svirant/RT4k_HD15_serial_control/HDMI Generic/README.md

## HDMI Generic

This guide should work with any switch that uses LEDs to indicate which input is active.

Picture guide coming soon...
