svirant/RT4k_HD15_serial_control/HDMI Generic/assets/6.jpeg

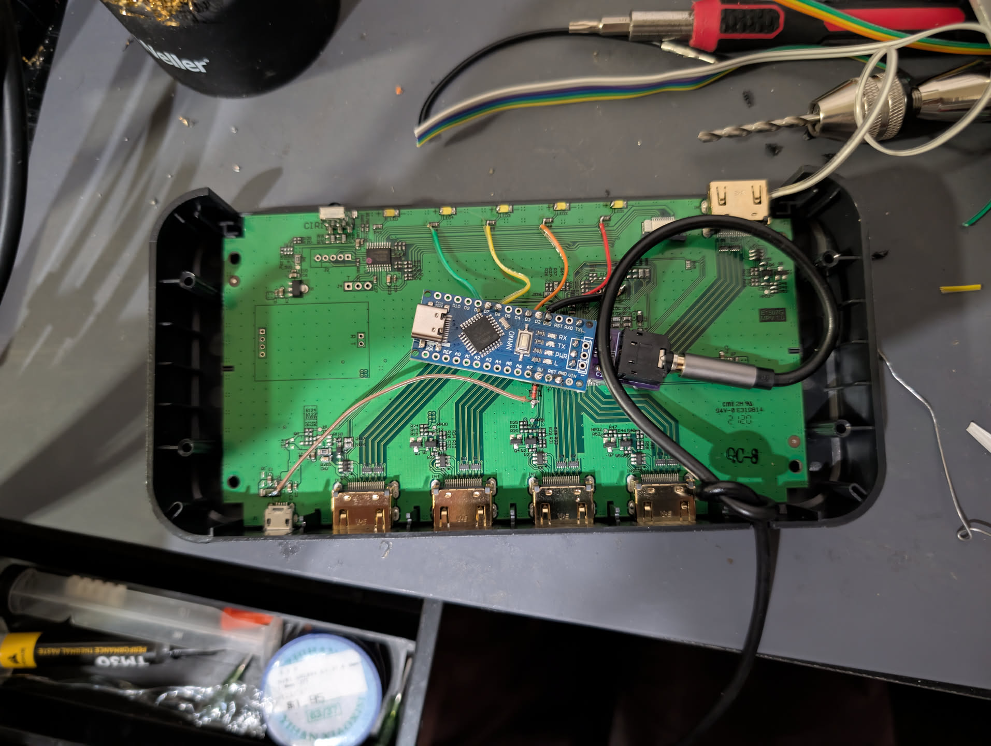
HDMI Generic/assets/6.jpeg
