svirant/RT4k_HD15_serial_control/DonutDongle/BOM-DonutDongle.csv

Comment | Quantity | Designator | Footprint | Part# | Digikey | AliExpress
Donut Dongle
0.1 uf / 100nf Capacitor | 4 | C1,C2,C3,C4 | C_0805_2012Metric | 311-1140-1-ND | https://www.digikey.com/en/products/detail/yageo/CC0805KRX7R9BB104/302874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
30 Ohm Resistor | 1 | R1 | R_0805_2012Metric | 10-ERJ-P06F30R0VCT-ND | https://www.digikey.com/en/products/detail/panasonic-electronic-components/ERJ-P06J102V/525197
1K Ohm Resistor | 1 | R2 | R_0805_2012Metric | P1.0KADCT-ND | https://www.digikey.com/en/products/detail/panasonic-electronic-components/ERJ-P06J102V/525197
10K Ohm Resistor | 6 | R3,R4,R5,R6,R7,R8 | R_0805_2012Metric | 311-10KLGCT-ND | https://www.digikey.com/en/products/detail/yageo/AC0805FR-0710KL/2827834
PJ-307 3.5mm Stereo Jack Socket Audio Jack Connector PCB 3F07 | 1 |  |  | PJ-307 |  | https://www.aliexpress.us/item/2251832712518602.html?sourceType=1
PJ-320 3.5MM Headphone Jack Audio Video Female | 4 |  |  | PJ-320 |  | https://www.aliexpress.us/item/3256805995568762.html?sourceType=1
DC3 10 Pin 2x5 Pin Double Row 2.54mm Pitch Straight Pin Male IDC Box Header Connector | 2 |  | 2x5 pin |  |  | https://www.aliexpress.us/item/2255800441397852.html?sourceType=1
2.54mm 2x4 Pin 8 Pin Straight Male Shrouded PCB Box header IDC Socket | 2 |  | 2x4 pin |  |  | https://www.aliexpress.us/item/2251801533534895.html?sourceType=1
CHF03 1.5 Meters IR Infrared Remote Emission Cable IR Emitter 5ft Emission Lines Extender Cord for IR Repeater Kit | 1 |  | 3.5mm TS male jack (optional) |  |  | https://www.aliexpress.us/item/3256805962345169.html?sourceType=1
3.5mm IR Infrared Remote Control Receiver Extension Cord Cable for Extender Repeater System IR Receiver Emitter for Set Top Box | 1 |  | 3.5mm TRS male jack (optional) |  |  | https://www.aliexpress.us/item/2251832741040177.html?sourceType=1
MAX3232CSE MAX3232 MAX3232ESE SOP-16 RS-232 Interface IC 3-5.5V MultiCh Line Driver/Receiver | 1 | U1 | SOP-16 | MAX3232 |  | https://www.aliexpress.us/item/3256807314260762.html?sourceType=1
Type-C Arduino Nano | 1 |  |  |  |  | https://www.aliexpress.us/item/3256806596798623.html?sourceType=1
NPN Transistor | 1 | Q1 |  | 2N3904 |  | https://www.aliexpress.us/item/3256806623522970.html?sourceType=1
2.54mm Pitch Single Row Female 15P PCB socket Board Pin Header Connector Strip Pinheader | 2 |  | 1x15 pin female header |  |  | https://www.aliexpress.us/item/3256801232229618.html?sourceType=1
2 Port DB9 RS232 Serial Port Bracket To IDC 10Pin Male Female Header Ribbon Cable Connector | 1 |  | DB9 to 2x5 pin header |  |  | https://www.aliexpress.us/item/3256807472891897.html?sourceType=1
Digikey shared list: | https://www.digikey.com/en/mylists/list/53XEHTQZJK
AliExpress shared list: | https://www.aliexpress.com/p/wish-manage/share.html?smbPageCode=wishlist-amp
Misc
3.5mm aux stereo cable(s)
usb-C cable for Arduino power and initial programming
YC2VGA
Yellow RCA Composite jack | 1 |  |  | Color: Yellow |  | https://www.aliexpress.us/item/3256805949533421.html?sourceType=1
S-Video jack | 1 |  |  | Color: B 4Pin |  | https://www.aliexpress.us/item/3256804041313042.html?sourceType=1
PJ-320 3.5MM Headphone Jack Audio Video Female | 1 |  |  | Color: 10PCS PJ-320 |  | https://www.aliexpress.us/item/3256805995568762.html?sourceType=1
VGA Male | 1 |  |  | L717HDE15PD4CH4R-ND |  | https://www.digikey.com/en/products/detail/amphenol-cs-commercial-products/L717HDE15PD4CH4R/4886543
VGAPass
VGA Male | 1 |  |  | 10090926-P156XLF-ND |  | https://www.digikey.com/en/products/detail/amphenol-cs-fci/10090926-P156XLF/4570100
VGA Female | 1 |  |  | Color: HDR15P Female 3.08 |  | https://www.aliexpress.us/item/3256806106796466.html?sourceType=1
PJ-320 3.5MM Headphone Jack Audio Video Female | 1 |  |  | Color: 10PCS PJ-320 |  | https://www.aliexpress.us/item/3256805995568762.html?sourceType=1
