svirant/RT4k_HD15_serial_control/Otaku Games Scart Switch/rt4k_serial_otaku_nano_blue_board.ino

/*
* RT4K Serial Otaku Games Scart Auto-switcher - Arduino Nano edition v0.2b
* Copyright (C) 2026 @Donutswdad
*
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
* You should have received a copy of the GNU General Public License
* along with this program.  If not, see <http://www.gnu.org/licenses/>.
*/

// RT4K HD15 serial remote control w/ Arduino Nano edition (5v tolerant)
//
// HD15 pin 15 = RX --> Arduino Nano TX pin
// HD15 pin 12 = TX --> Arduino Nano RX pin (not needed for this project, you can leave disconnected)
// HD15 pin 5 = Gnd --> Arduino Gnd pin (any Gnd pin is fine)

uint8_t const SVS = 0;     // 0 - use "Remote" button profiles 1-10
                           // 1 - use SVS profiles S1_<whatever>.rt4 - S10_<whatever>.rt4.
                           //     Ex: when combined with an offset of say "offset = 600" as an example, this would translate to SVS profiles S601_<whatever>.rt4 - S610_<whatever>.rt4

uint16_t const offset = 0; // by default SVS profiles 1 - 10 will be used. set the offset to add this number so they dont conflict with another SVS device.
                           // Ex: offset = 600 would give you SVS profiles 601-610.

bool ScartOffProfile = true;  //set to "true" loads Remote Profile 12 when all scart inputs are off. You can assign it to a generic HDMI input profile for example.
                              // When used with a Donut Dongle this allows it to fallback to another active switch.
                              //
                              //set to "false" always leaves the last active scart input profile loaded
                              //set to "true" by default
                              
uint16_t scart1 = 0x0f; //used to store state of first grouping of scart ports
uint16_t scart2 = 0x0f; //second grouping...
uint8_t scartoff = 1; //used to keep track of scart off profile state, if enabled
uint8_t scartoffprev = 1; //used to store previous state of scartoff
uint16_t scart1prev = 0x0f; //used to store previous state of first group
uint16_t scart2prev = 0x0f; 


void setup(){
    
    Serial.begin(9600); // Set the baud rate for the RT4K Serial Connection
    while(!Serial){;}   // allow connection to establish before continuing
    Serial.println(F("\r")); // when the Arduino first powers on, it sends garbage bytes out the hardware serial port. this shows up in the RT4K diag screen.
                          // sending a carriage return clears out the buffer so the first input change works correctly
    DDRD  &= ~B11111100; // Set PD2-7 as inputs (shown on nano as pins D2-D7)
    DDRB  &= ~B00001111; // Set PB0 - PB4 as inputs (shown on nano as pins D8-11)
    
} // end of setup()

void loop(){

readScart();

delay(250);

} // end of loop()

void readScart(){
    // Read scart ports (bitwise NOT results in a 1 when scart port is Active / Low voltage on uln2003 leg)
    //
    // If you are wanting to use this for a different application where an Active port is High instead of Low,
    // replace this following with this instead: (removing the ~)
    //
    // scart1 = (PIND & B11111100);
    // scart2 = (PINB & B00011111);
    //
    // Also comment out the PORTD, PORTB lines above to disable the internal pull-up resistors.
    
    // Read scart ports (bitwise NOT results in a 1 when scart port is active)
    scart1 = ~(PIND & B11111100); //read pins D2-D7
    scart2 = ~(PINB & B00001111); //read pins D8-D11
    scartoff = (!(scart1 & B11111100) && !(scart2 & B00001111));

    // Has active scart port changed? Group 1
    if(scart1 != scart1prev){
      //Detect which scart port is now active and change profile accordingly
      if(scart1 & B01000000){ //Pin D6
        if(SVS) sendSVS(1);
        else Serial.println(F("remote prof1\r"));
      }
      else if(scart1 & B00100000){ //Pin D5
        if(SVS) sendSVS(2);
        else Serial.println(F("remote prof2\r"));
      }
      else if(scart1 & B00010000){ //Pin D4
        if(SVS) sendSVS(3);
        else Serial.println(F("remote prof3\r"));
      }
      else if(scart1 & B00001000){ //Pin D3
        if(SVS) sendSVS(4);
        else Serial.println(F("remote prof4\r"));
      }
      else if(scart1 & B00000100){ //Pin D2
        if(SVS) sendSVS(5);
        else Serial.println(F("remote prof5\r"));
      }
      else if(scart1 & B10000000){ //Pin D7
        if(SVS) sendSVS(10);
        else Serial.println(F("remote prof10\r"));
      }
      scart1prev = scart1;
    }
    
    // Has active scart port changed? Group 2
    if(scart2 != scart2prev){
      //Detect which scart port is now active and change profile accordingly
      if(scart2 & B00000001){ //Pin D8
        if(SVS) sendSVS(9);
        else Serial.println(F("remote prof9\r"));
      }
      else if(scart2 & B00000010){ //Pin D9
        if(SVS) sendSVS(8);
        else Serial.println(F("remote prof8\r"));
      }
      else if(scart2 & B00000100){ //Pin D10
        if(SVS) sendSVS(7);
        else Serial.println(F("remote prof7\r"));
      }
      else if(scart2 & B00001000){ //Pin D11
        if(SVS) sendSVS(6);
        else Serial.println(F("remote prof6\r"));
      }

      scart2prev = scart2;
    }

    // If all ports are in-active, load profile 12. You can assign it to a generic HDMI profile for example.
    if((scartoff != scartoffprev) && ScartOffProfile){
      if(((scart1 & B11111100) + (scart2 & B00001111)) == 0){
        if(SVS) sendSVS(0);
        else Serial.println(F("remote prof12\r"));
      }
        
      scartoffprev = scartoff;
    }
} // end of readScart()

void sendSVS(uint16_t num){
  Serial.print(F("\rSVS NEW INPUT="));
  Serial.print(num + offset);
  Serial.println(F("\r"));
  delay(1000);
  Serial.print(F("\rSVS CURRENT INPUT="));
  Serial.print(num + offset);
  Serial.println(F("\r"));
}
