svirant/RT4k_HD15_serial_control/(commit log)

2024-11-27 Arduino Nano edition added (5v tolerant)
2024-11-27 Arduino Pro Micro (not 5v tolerant unless voltage divider is used)
2024-11-27 added Arduino Nano instructions / layout
2024-12-01 EXPERIMENTAL - not tested versions
    I don't have the switches to test on, but according to everything I've read, this "should" work :)
2024-12-04 added support for devices with 12 inputs, more possible if SVS commands are used
2024-12-04 added support for MVX input devices
2024-12-04 support for most Extron devices that use SIS
2024-12-04 added notes about Extron switches
2024-12-06 fixed a bug so that the first input change after Arduino power on works correctly
2024-12-09 added SVS profile support, RT5X support via IR LED add-on
2024-12-09 RT5X IR LED support, RT4K as well
2024-12-10 updated support for 2 Extron switches, each with 99 inputs and 32 outputs allowed.
2024-12-10 additional instructions for 2nd Extron switch connection
2024-12-16 renamed variable to make more sense, fixed edge case for Default Profile 0 loading
2024-12-16 optimized Serial.print to use less SRAM. tweaked Extron serial buffer reads, moved code into functions
2024-12-17 new edge case discovered and accounted for
2024-12-17 updated Otaku Games Scart Switch guide photos
2024-12-17 updated based on actual implementation. removed extra port detection pin
2024-12-19 rearranged Otaku Games Scart Switch section
2024-12-20 Serial relay for the Tink's IR remote control
    With an IR Receiver connected to the Arduino that has must better reception, RT4K IR remote control button presses get relayed through the RetroTink 4K's serial interface instead. Ultimately making the remote control much more responsive. Can also be used when the RetroTink's IR window is hidden or not easily reached by the IR of the remote.
2024-12-22 fixed power button functionality, toggles between off/on
2024-12-26 Update and rename BOM-DonutDongle.csv to BOM-donut_dongle.csv
    [BOM-donut_dongle.csv]
2024-12-26 rename folder
    [BOM-donut_dongle.csv]
2024-12-28 added IR emitter option for TESmart HDMI switch
2024-12-28 direction button hold down behavior for the Serial remote now matches that of the native IR remote
2024-12-29 extra button profile functionality added, AUX8 then profile button# loads SVS 301 - 312
2024-12-29 press AUX8 twice, then you can manually enter the SVS profile using the profile buttons. 1-9 and 0 with 10,11, or 12 button
2024-12-29 remote feature: press AUX8 twice, then you can manually enter the SVS profile using the profile buttons. 1-9 and 0 with 10,11, or 12 button
2025-01-02 YC2VGA gerber
2025-01-02 Update and rename YC2VGA-BOM.csv to YC2VGA_shorty-BOM.csv
    [YC2VGA_shorty-BOM.csv]
2025-01-02 YC2VGA shorty gerber added
2025-01-03 customize AUX8 + profile button to be ANY SVS profile
2025-01-20 no need for wiring "Rx" notice
2025-05-06 updated Notice about 10k resistor inline with Tx -> Rx
2025-05-25 .INO file for the blue OtakuGames Switch board.
    This is a .ino file with different pinouts from the other rt4k_serial_otaku_nano.ino as it puts to mind the different pinout of the ULN2003C Darlington Arrays. The S0 logic starting from line 132 has been commented out.
2025-05-25 Blue Board Instructions
2025-06-17 Added to Documentation, added Gerber for PCB.
2025-06-18 Changes for PR, added clarification about push-pull still being viable, changed title on green board, fixed typos.
2026-04-28 support for Otaku Games 6 Port RCA switch added
2026-04-28 added README and helper pcb
2026-10-28 Added generalized instructions and a new ino file for HDMI switches.
2026-11-01 Generalized instructions for Otaku switches.
2026-11-01 Changed HDMI .ino to match the SCART switch's. Put Step 0 from the Otaku guide in the HDMI guide.
2026-11-02 Put pin bounds in an int variable at the top for easier config. Added S0 to the Otaku ino.
2026-11-02 Fixed broken link in both READMEs. Put the PCB files in an easy-to-find location.
