svirant/RT4k_HD15_serial_control/(notices)

Notices in the files:
Otaku Games Scart Switch/rt4k_serial_otaku_nano_blue_board.ino:
This program is free software: you can redistribute it and/or modify
it under the terms of the GNU General Public License as published by
the Free Software Foundation, either version 3 of the License, or
(at your option) any later version.
